Pinoccio/test-pinoccio/README.md

pinoccio-test-harness
=====================
