Pinoccio/test-pinoccio/eagle/pinoccio-test.brd

## EAGLE design eagle/pinoccio-test.brd (2014-06-06)

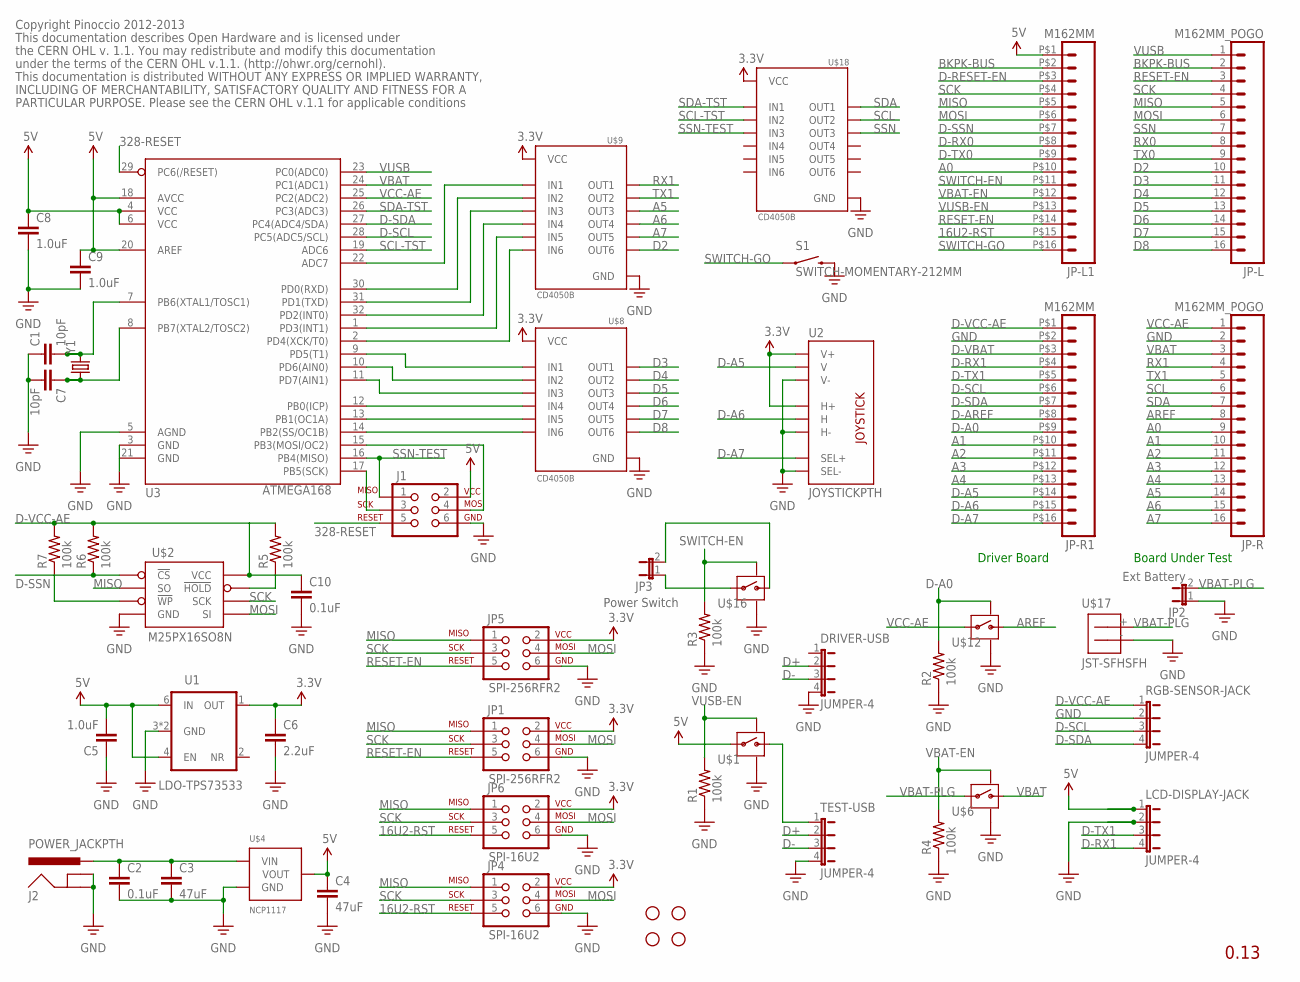
[picture p1: schematic pinoccio-test.sch]

Parts:
C1, C7: 10pF; 0402-CAP
C2, C10: 0.1uF; 0402-CAP
C3, C4: 47uF; 0805
C5, C8, C9: 1.0uF; 0402-CAP
C6: 2.2uF; 0402-CAP
DRIVER-USB: JUMPER-4; 1X04
J1: SPI-328P; 2X3
J2: POWER_JACKPTH; POWER_JACK_PTH
JP1, JP5: SPI-256RFR2; 2X3
JP2: Ext Battery; 1X02
JP3: Power Switch; 1X02
JP4, JP6: SPI-16U2; 2X3
JP7, JP9, JP10, JP12: STAND-OFF
JP-L: M162MM_POGO; 1X16_2MM_POGO
JP-L1: M162MM; 1X16_2MM
JP-R: M162MM_POGO; 1X16_2MM_POGO
JP-R1: M162MM; 1X16_2MM
LCD-DISPLAY-JACK: JUMPER-4; 1X04
R1, R2, R3, R4, R5, R6, R7: 100k; 0402-RES
RGB-SENSOR-JACK: JUMPER-4; 1X04
S1: SWITCH-MOMENTARY-212MM; TACTILE-PTH-12MM
TEST-USB: JUMPER-4; 1X04
U1: LDO-TPS73533; SON-6-DRV
U2: JOYSTICKPTH; JOYSTICK
U3: ATMEGA168; TQFP32-08
U$1, U$6, U$12, U$16: SWITCH-MOSFETTDFN4; TDFN4
U$2: M25PX16SO8N; SO8N
U$4: NCP1117; SOT223
U$8, U$9, U$18: CD4050B; TSSOP-16
U$17: JST-SFHSFH; JST-SFH
Y1: CRYSTALABM10; CRYSTAL-SMD-2.5X2-ABM10

Connections:
3.3V: C6.1, JP1.2, JP4.2, JP5.2, JP6.2, U1.1 (OUT), U2.H1 (H+), U2.V1 (V+), U$8.1 (VCC), U$9.1 (VCC), U$18.1 (VCC)
5V: C4.1, C5.2, C8.1, C9.1, J1.2, JP-L1.P$1 (1), LCD-DISPLAY-JACK.1, U1.4 (EN), U1.6 (IN), U3.4 (VCC), U3.6 (VCC), U3.18 (AVCC), U3.20 (AREF), U$1.P$3 (IN), U$4.2 (VOUT), U$4.4 (VOUT)
16U2-RST: JP4.5, JP6.5, JP-L1.P$15 (15)
328-RESET: J1.5, U3.29 (PC6(/RESET))
A0: JP-L1.P$10 (10), JP-R.9
A1: JP-R.10, JP-R1.P$10 (10)
A2: JP-R.11, JP-R1.P$11 (11)
A3: JP-R.12, JP-R1.P$12 (12)
A4: JP-R.13, JP-R1.P$13 (13)
A5: JP-R.14, U$9.6 (OUT3)
A6: JP-R.15, U$9.10 (OUT4)
A7: JP-R.16, U$9.12 (OUT5)
AREF: JP-R.8, U$12.P$1 (OUT)
BKPK-BUS: JP-L.2, JP-L1.P$2 (2)
D2: JP-L.10, U$9.15 (OUT6)
D3: JP-L.11, U$8.2 (OUT1)
D4: JP-L.12, U$8.4 (OUT2)
D5: JP-L.13, U$8.6 (OUT3)
D6: JP-L.14, U$8.10 (OUT4)
D7: JP-L.15, U$8.12 (OUT5)
D8: JP-L.16, U$8.15 (OUT6)
D+: DRIVER-USB.2, TEST-USB.2
D-: DRIVER-USB.3, TEST-USB.3
D-A0: JP-R1.P$9 (9), R2.2, U$12.P$4 (ON)
D-A5: JP-R1.P$14 (14), U2.V2 (V)
D-A6: JP-R1.P$15 (15), U2.H2 (H)
D-A7: JP-R1.P$16 (16), U2.B1A (SEL+)
D-AREF: JP-R1.P$8 (8)
D-RESET-EN: JP-L1.P$3 (3)
D-RX0: JP-L1.P$8 (8)
D-RX1: JP-R1.P$4 (4), LCD-DISPLAY-JACK.4
D-SCL: JP-R1.P$6 (6), RGB-SENSOR-JACK.3, U3.28 (PC5(ADC5/SCL))
D-SDA: JP-R1.P$7 (7), RGB-SENSOR-JACK.4, U3.27 (PC4(ADC4/SDA))
D-SSN: JP-L1.P$7 (7), R6.1, U$2.1 (!CS)
D-TX0: JP-L1.P$9 (9)
D-TX1: JP-R1.P$5 (5), LCD-DISPLAY-JACK.3
D-VBAT: JP-R1.P$3 (3)
D-VCC-AE: C10.1, JP-R1.P$1 (1), R5.2, R6.2, R7.2, RGB-SENSOR-JACK.1, U$2.8 (VCC)
GND: C1.1, C2.2, C3.2, C4.2, C5.1, C6.2, C7.2, C8.2, C9.2, C10.2, DRIVER-USB.4, J1.6, J2.GND, J2.GNDBREAK, JP1.6, JP2.1, JP4.6, JP5.6, JP6.6, JP-R.2, JP-R1.P$2 (2), LCD-DISPLAY-JACK.2, R1.1, R2.1, R3.1, R4.1, RGB-SENSOR-JACK.2, S1.3 (2), TEST-USB.4, U1.3 (GND), U1.PAD (GND), U2.B2A (SEL-), U2.H3 (H-), U2.V3 (V-), U3.3 (GND), U3.5 (AGND), U$1.P$2 (GND), U$1.P$5 (GND), U$2.4 (GND), U$4.1 (GND), U$6.P$2 (GND), U$6.P$5 (GND), U$8.8 (GND), U$9.8 (GND), U$12.P$2 (GND), U$12.P$5 (GND), U$16.P$2 (GND), U$16.P$5 (GND), U$17.-, U$18.8 (GND), Y1.P$2 (GND), Y1.P$4 (GND)
MISO: JP1.1, JP4.1, JP5.1, JP6.1, JP-L.5, JP-L1.P$5 (5), U$2.2 (SO)
MOSI: JP1.4, JP4.4, JP5.4, JP6.4, JP-L.6, JP-L1.P$6 (6), U$2.5 (SI)
unnamed: U3.2 (PD4(XCK/T0)), U$9.14 (IN6)
unnamed: U3.1 (PD3(INT1)), U$9.11 (IN5)
unnamed: U3.14 (PB2(SS/OC1B)), U$8.14 (IN6)
unnamed: C2.1, C3.1, J2.PWR, U$4.3 (VIN)
unnamed: U3.32 (PD2(INT0)), U$9.9 (IN4)
unnamed: C1.2, U3.7 (PB6(XTAL1/TOSC1)), Y1.P$3 (2)
unnamed: U3.31 (PD1(TXD)), U$9.7 (IN3)
unnamed: U3.13 (PB1(OC1A)), U$8.11 (IN5)
unnamed: U3.30 (PD0(RXD)), U$9.5 (IN2)
unnamed: U3.22 (ADC7), U$9.3 (IN1)
unnamed: U3.12 (PB0(ICP)), U$8.9 (IN4)
unnamed: JP3.2, U$16.P$1 (OUT)
unnamed: U3.11 (PD7(AIN1)), U$8.7 (IN3)
unnamed: C7.1, U3.8 (PB7(XTAL2/TOSC2)), Y1.P$1 (1)
unnamed: JP3.1, U$16.P$3 (IN)
unnamed: TEST-USB.1, U$1.P$1 (OUT)
unnamed: R7.1, U$2.3 (!WP)
unnamed: R5.1, U$2.7 (!HOLD)
unnamed: U3.10 (PD6(AIN0)), U$8.5 (IN2)
unnamed: U3.9 (PD5(T1)), U$8.3 (IN1)
unnamed: J1.4, U3.15 (PB3(MOSI/OC2))
unnamed: J1.3, U3.17 (PB5(SCK))
RESET-EN: JP1.5, JP5.5, JP-L.3, JP-L1.P$14 (14)
RX0: JP-L.8
RX1: JP-R.4, U$9.2 (OUT1)
SCK: JP1.3, JP4.3, JP5.3, JP6.3, JP-L.4, JP-L1.P$4 (4), U$2.6 (SCK)
SCL: JP-R.6, U$18.4 (OUT2)
SCL-TST: U3.19 (ADC6), U$18.5 (IN2)
SDA: JP-R.7, U$18.2 (OUT1)
SDA-TST: U3.26 (PC3(ADC3)), U$18.3 (IN1)
SSN: JP-L.7, U$18.6 (OUT3)
SSN-TEST: J1.1, U3.16 (PB4(MISO)), U$18.7 (IN3)
SWITCH-EN: JP-L1.P$11 (11), R3.2, U$16.P$4 (ON)
SWITCH-GO: JP-L1.P$16 (16), S1.1
TX0: JP-L.9
TX1: JP-R.5, U$9.4 (OUT2)
VBAT: JP-R.3, U3.24 (PC1(ADC1)), U$6.P$1 (OUT)
VBAT-EN: JP-L1.P$12 (12), R4.2, U$6.P$4 (ON)
VBAT-PLG: JP2.2, U$6.P$3 (IN), U$17.+
VCC-AE: JP-R.1, U3.25 (PC2(ADC2)), U$12.P$3 (IN)
VUSB: JP-L.1, U3.23 (PC0(ADC0))
VUSB-EN: JP-L1.P$13 (13), R1.2, U$1.P$4 (ON)

Notes on the sheet:
0.13
Copyright Pinoccio 2012-2013
This documentation describes Open Hardware and is licensed under
the CERN OHL v. 1.1. You may redistribute and modify this documentation
under the terms of the CERN OHL v.1.1. (http://ohwr.org/cernohl).
This documentation is distributed WITHOUT ANY EXPRESS OR IMPLIED WARRANTY,
INCLUDING OF MERCHANTABILITY, SATISFACTORY QUALITY AND FITNESS FOR A
PARTICULAR PURPOSE. Please see the CERN OHL v.1.1 for applicable conditions
Driver Board
Board Under Test

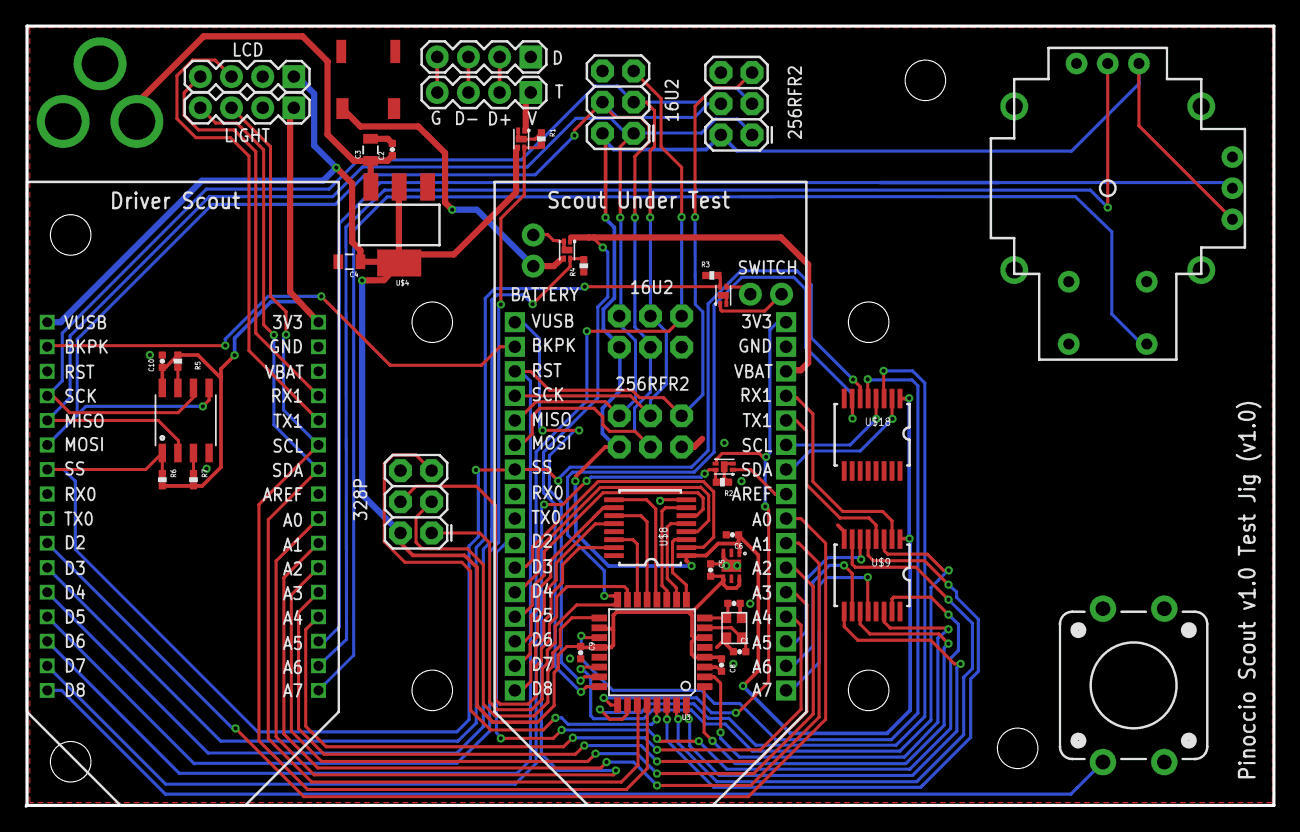
[picture p2: board pinoccio-test.brd from above]

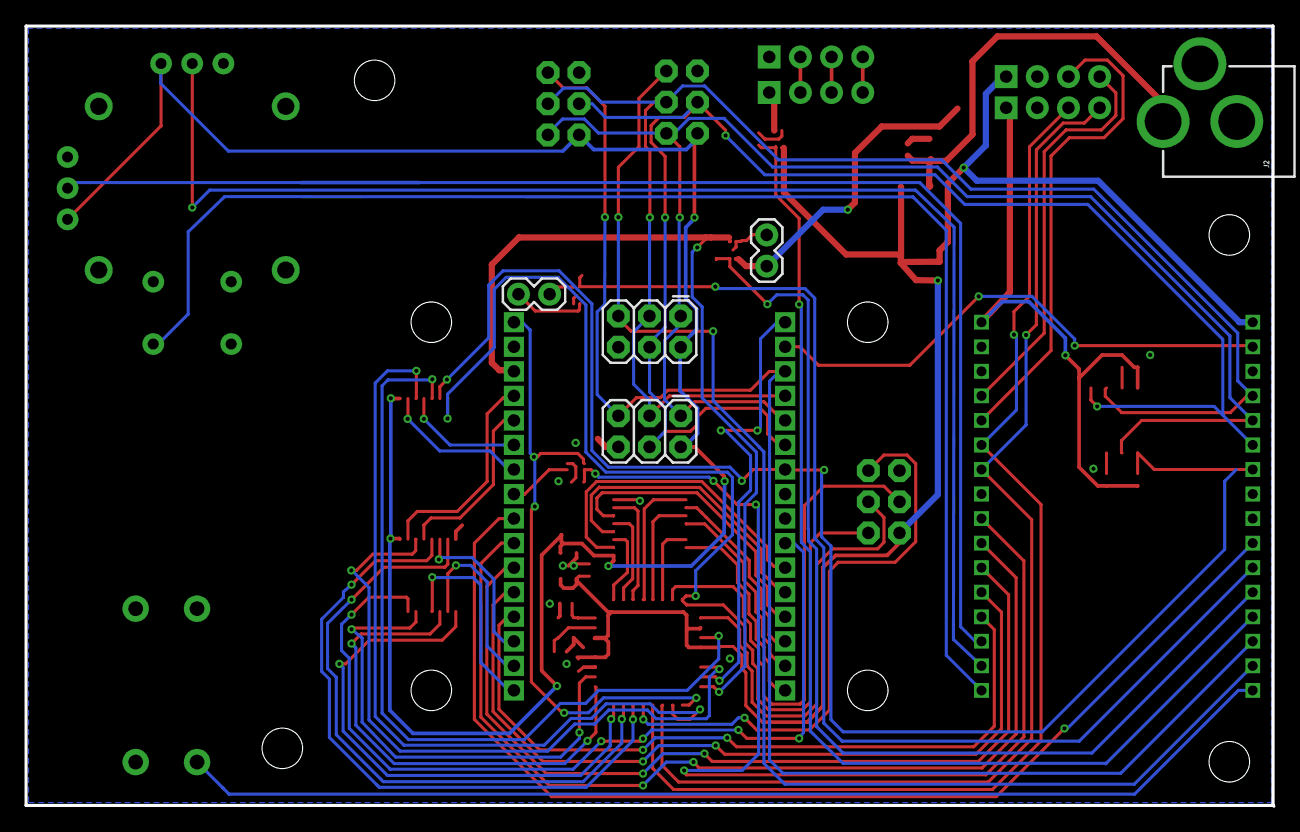
[picture p3: board pinoccio-test.brd from below]

Board: 2 copper layers, 101.6 x 63.5 mm, 56 parts (5 on the bottom side), 76 nets.

Other parts of the board:
JP8, JP11, JP13, JP14: STAND-OFF
