Pinoccio/test-pinoccio/firmware/SerialTunnel/SerialTunnel.ino

void setup() {
  Serial.begin(115200);
  Serial1.begin(115200);
   
  // uncomment these if you want to put the WiFi module into firmware update mode
  //pinMode(6, OUTPUT);
  //digitalWrite(6, HIGH);
  
  pinMode(VCC_ENABLE, OUTPUT);
  digitalWrite(VCC_ENABLE, HIGH);
  pinMode(8, OUTPUT);
  digitalWrite(8, LOW);
  delay(1000);
  digitalWrite(8, HIGH);
}

void loop() {

  // read from port 1, send to port 0:
  while (Serial1.available()) {
    int inByte = Serial1.read();
    Serial.write(inByte); 
  }

  // read from port 0, send to port 1:
  while (Serial.available()) {
    int inByte = Serial.read();
    Serial1.write(inByte); 
  }
}
