Pinoccio/test-pinoccio/firmware/PinoccioTestSuite/bootloader_atmega256rfr2.h

// ---------------------------------------------------------
// File =  boot_pinoccio.hex
// Loader start: 3E000, length: 8192
// MD5 sum = 85 11 97 C0 F7 AF 96 CC B7 A1 2E F6 38 16 53 92 

const byte PROGMEM atmega256rfr2_bootloader [] = {
0x99, 0xC0, 0x00, 0x00, 0xBE, 0xC0, 0x00, 0x00, 0xBC, 0xC0, 0x00, 0x00, 0xBA, 0xC0, 0x00, 0x00, 
0xB8, 0xC0, 0x00, 0x00, 0xB6, 0xC0, 0x00, 0x00, 0xB4, 0xC0, 0x00, 0x00, 0xB2, 0xC0, 0x00, 0x00, 
0xB0, 0xC0, 0x00, 0x00, 0xAE, 0xC0, 0x00, 0x00, 0xAC, 0xC0, 0x00, 0x00, 0xAA, 0xC0, 0x00, 0x00, 
0xA8, 0xC0, 0x00, 0x00, 0xA6, 0xC0, 0x00, 0x00, 0xA4, 0xC0, 0x00, 0x00, 0xA2, 0xC0, 0x00, 0x00, 
0xA0, 0xC0, 0x00, 0x00, 0x9E, 0xC0, 0x00, 0x00, 0x9C, 0xC0, 0x00, 0x00, 0x9A, 0xC0, 0x00, 0x00, 
0x98, 0xC0, 0x00, 0x00, 0x96, 0xC0, 0x00, 0x00, 0x94, 0xC0, 0x00, 0x00, 0x92, 0xC0, 0x00, 0x00, 
0x90, 0xC0, 0x00, 0x00, 0x8E, 0xC0, 0x00, 0x00, 0x8C, 0xC0, 0x00, 0x00, 0x8A, 0xC0, 0x00, 0x00, 
0x88, 0xC0, 0x00, 0x00, 0x86, 0xC0, 0x00, 0x00, 0x84, 0xC0, 0x00, 0x00, 0x82, 0xC0, 0x00, 0x00, 
0x80, 0xC0, 0x00, 0x00, 0x7E, 0xC0, 0x00, 0x00, 0x7C, 0xC0, 0x00, 0x00, 0x7A, 0xC0, 0x00, 0x00, 
0x78, 0xC0, 0x00, 0x00, 0x76, 0xC0, 0x00, 0x00, 0x74, 0xC0, 0x00, 0x00, 0x72, 0xC0, 0x00, 0x00, 
0x70, 0xC0, 0x00, 0x00, 0x6E, 0xC0, 0x00, 0x00, 0x6C, 0xC0, 0x00, 0x00, 0x6A, 0xC0, 0x00, 0x00, 
0x68, 0xC0, 0x00, 0x00, 0x66, 0xC0, 0x00, 0x00, 0x64, 0xC0, 0x00, 0x00, 0x62, 0xC0, 0x00, 0x00, 
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
0xFF, 0x90, 0xC5, 0xCF, 0xDF, 0x92, 0xEF, 0x92, 0xFF, 0x92, 0x0F, 0x93, 0x1F, 0x93, 0xCF, 0x93, 
0xDF, 0x93, 0x8C, 0x01, 0xD6, 0x2E, 0x7A, 0x01, 0xE9, 0x01, 0x20, 0x97, 0x49, 0xF0, 0x47, 0xE0, 
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
}; // end of boot_pinoccio_hex
