Pinoccio/test-pinoccio/firmware/PinoccioTestSuiteI2C/bootloader_atmega256rfr2.h

// File =  atmega256rfr2.hex
// Loader start: 3E000, length: 8192
// MD5 sum = 04 1A 16 F4 9A CE 01 A2 22 EB CB 41 4E DA 70 F1 

const byte PROGMEM atmega256rfr2_bootloader [] = {
0x0D, 0x94, 0xB4, 0xF1, 0x0D, 0x94, 0xDD, 0xF1, 0x0D, 0x94, 0xDD, 0xF1, 0x0D, 0x94, 0xDD, 0xF1, 
0x0D, 0x94, 0xDD, 0xF1, 0x0D, 0x94, 0xDD, 0xF1, 0x0D, 0x94, 0xDD, 0xF1, 0x0D, 0x94, 0xDD, 0xF1, 
0x0D, 0x94, 0xDD, 0xF1, 0x0D, 0x94, 0xDD, 0xF1, 0x0D, 0x94, 0xDD, 0xF1, 0x0D, 0x94, 0xDD, 0xF1, 
0x0D, 0x94, 0xDD, 0xF1, 0x0D, 0x94, 0xDD, 0xF1, 0x0D, 0x94, 0xDD, 0xF1, 0x0D, 0x94, 0xDD, 0xF1, 
0x0D, 0x94, 0xDD, 0xF1, 0x0D, 0x94, 0xDD, 0xF1, 0x0D, 0x94, 0xDD, 0xF1, 0x0D, 0x94, 0xDD, 0xF1, 
0x0D, 0x94, 0xDD, 0xF1, 0x0D, 0x94, 0xDD, 0xF1, 0x0D, 0x94, 0xDD, 0xF1, 0x0D, 0x94, 0xDD, 0xF1, 
0x0D, 0x94, 0xDD, 0xF1, 0x0D, 0x94, 0xDD, 0xF1, 0x0D, 0x94, 0xDD, 0xF1, 0x0D, 0x94, 0xDD, 0xF1, 
0x0D, 0x94, 0xDD, 0xF1, 0x0D, 0x94, 0xDD, 0xF1, 0x0D, 0x94, 0xDD, 0xF1, 0x0D, 0x94, 0xDD, 0xF1, 
0x0D, 0x94, 0xDD, 0xF1, 0x0D, 0x94, 0xDD, 0xF1, 0x0D, 0x94, 0xDD, 0xF1, 0x0D, 0x94, 0xDD, 0xF1, 
0x0D, 0x94, 0xDD, 0xF1, 0x0D, 0x94, 0xDD, 0xF1, 0x0D, 0x94, 0xDD, 0xF1, 0x0D, 0x94, 0xDD, 0xF1, 
0x0D, 0x94, 0xDD, 0xF1, 0x0D, 0x94, 0xDD, 0xF1, 0x0D, 0x94, 0xDD, 0xF1, 0x0D, 0x94, 0xDD, 0xF1, 
0x0D, 0x94, 0xDD, 0xF1, 0x0D, 0x94, 0xDD, 0xF1, 0x0D, 0x94, 0xDD, 0xF1, 0x0D, 0x94, 0xDD, 0xF1, 
0x0D, 0x94, 0xDD, 0xF1, 0x0D, 0x94, 0xDD, 0xF1, 0x0D, 0x94, 0xDD, 0xF1, 0x0D, 0x94, 0xDD, 0xF1, 
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
0x63, 0x74, 0x69, 0x6F, 0x6E, 0x20, 0x61, 0x64, 0x64, 0x72, 0x20, 0x20, 0x20, 0x49, 0x6E, 0x74, 
0x65, 0x72, 0x72, 0x75, 0x70, 0x74, 0x00, 0x34, 0x2E, 0x37, 0x2E, 0x33, 0x00, 0x31, 0x2E, 0x38, 
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
}; // end of atmega256rfr2_hex
