Pinoccio/test-pinoccio/firmware/PinoccioTestSuiteI2C/bootloader_attiny13a.h

const byte PROGMEM attiny13a [] = {
0x3a, 0x31, 0x30, 0x30, 0x30, 0x30, 0x30, 0x30, 0x30, 0x30, 0x39, 0x43, 0x30, 0x43, 0x33, 0x43, 0x30, 0x30, 0x44, 0x43, 0x30, 0x30, 0x43, 0x43, 0x30, 0x30, 0x42, 0x43, 0x30, 0x30, 0x41, 0x43, 0x30, 0x32, 0x39, 0x43, 0x31, 0x36, 0x42, 0x43, 0x31, 0x36, 0x30, 0x0d, 0x0a, 0x3a, 0x31, 0x30, 0x30, 0x30, 0x31, 0x30, 0x30, 0x30, 0x30, 0x37, 0x43, 0x30, 0x30, 0x36, 0x43, 0x30, 0x31, 0x31, 0x32, 0x34, 0x31, 0x46, 0x42, 0x45, 0x43, 0x46, 0x45, 0x39, 0x43, 0x44, 0x42, 0x46, 0x38, 0x36, 0x44, 0x31, 0x38, 0x38, 0x43, 0x31, 0x35, 0x44, 0x0d, 0x0a, 0x3a, 0x31, 0x30, 0x30, 0x30, 0x32, 0x30, 0x30, 0x30, 0x45, 0x46, 0x43, 0x46, 0x31, 0x30, 0x45, 0x30, 0x35, 0x35, 0x32, 0x34, 0x35, 0x41, 0x39, 0x34, 0x38, 0x45, 0x45, 0x46, 0x36, 0x38, 0x32, 0x32, 0x37, 0x31, 0x32, 0x43, 0x38, 0x31, 0x32, 0x43, 0x36, 0x41, 0x0d, 0x0a, 0x3a, 0x31, 0x30, 0x30, 0x30, 0x33, 0x30, 0x30, 0x30, 0x38, 0x35, 0x45, 0x31, 0x38, 0x37, 0x42, 0x42, 0x38, 0x38, 0x42, 0x42, 0x38, 0x39, 0x45, 0x36, 0x38, 0x39, 0x42, 0x44, 0x38, 0x30, 0x45, 0x34, 0x38, 0x42, 0x42, 0x46, 0x38, 0x32, 0x45, 0x30, 0x31, 0x30, 0x0d, 0x0a, 0x3a, 0x31, 0x30, 0x30, 0x30, 0x34, 0x30, 0x30, 0x30, 0x38, 0x33, 0x42, 0x46, 0x38, 0x35, 0x42, 0x37, 0x38, 0x30, 0x36, 0x32, 0x38, 0x35, 0x42, 0x46, 0x37, 0x38, 0x39, 0x34, 0x30, 0x38, 0x39, 0x35, 0x38, 0x35, 0x45, 0x30, 0x37, 0x38, 0x31, 0x32, 0x37, 0x34, 0x0d, 0x0a, 0x3a, 0x31, 0x30, 0x30, 0x30, 0x35, 0x30, 0x30, 0x30, 0x36, 0x43, 0x43, 0x30, 0x38, 0x38, 0x32, 0x44, 0x38, 0x34, 0x33, 0x30, 0x44, 0x31, 0x46, 0x31, 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
}; // end
