Pinoccio/test-pinoccio/firmware/PinoccioTestSuiteI2C/flash_atmega256rfr2.h

const byte PROGMEM atmega256rfr2_flash_0 [] = {
0x0C, 0x94, 0xA4, 0x04, 0x0C, 0x94, 0xD5, 0x04, 0x0C, 0x94, 0xD5, 0x04, 0x0C, 0x94, 0xD5, 0x04, 
0x0C, 0x94, 0xD5, 0x04, 0x0C, 0x94, 0xD5, 0x04, 0x0C, 0x94, 0xD5, 0x04, 0x0C, 0x94, 0xD5, 0x04, 
0x0C, 0x94, 0xD5, 0x04, 0x0C, 0x94, 0xD5, 0x04, 0x0C, 0x94, 0xD5, 0x04, 0x0C, 0x94, 0xD5, 0x04, 
0x0C, 0x94, 0xD5, 0x04, 0x0C, 0x94, 0xC5, 0x2A, 0x0C, 0x94, 0xD5, 0x04, 0x0C, 0x94, 0xD5, 0x04, 
0x0C, 0x94, 0xD5, 0x04, 0x0C, 0x94, 0xD5, 0x04, 0x0C, 0x94, 0xD5, 0x04, 0x0C, 0x94, 0xD5, 0x04, 
0x0C, 0x94, 0xD5, 0x04, 0x0C, 0x94, 0xD5, 0x04, 0x0C, 0x94, 0xD5, 0x04, 0x0C, 0x94, 0x1E, 0x4B, 
0x0C, 0x94, 0xD5, 0x04, 0x0C, 0x94, 0x6B, 0x4F, 0x0C, 0x94, 0xEB, 0x4F, 0x0C, 0x94, 0xD5, 0x04, 
0x0C, 0x94, 0xD5, 0x04, 0x0C, 0x94, 0x6C, 0x2B, 0x0C, 0x94, 0xD5, 0x04, 0x0C, 0x94, 0xD5, 0x04, 
0x0C, 0x94, 0xD5, 0x04, 0x0C, 0x94, 0xD5, 0x04, 0x0C, 0x94, 0xD5, 0x04, 0x0C, 0x94, 0xD5, 0x04, 
0x0C, 0x94, 0xA3, 0x4F, 0x0C, 0x94, 0x2A, 0x50, 0x0C, 0x94, 0xD5, 0x04, 0x0C, 0x94, 0x3E, 0x0D, 
0x0C, 0x94, 0xD5, 0x04, 0x0C, 0x94, 0xD5, 0x04, 0x0C, 0x94, 0xC4, 0x2B, 0x0C, 0x94, 0xD5, 0x2B, 
0x0C, 0x94, 0xD5, 0x04, 0x0C, 0x94, 0xD5, 0x04, 0x0C, 0x94, 0xD5, 0x04, 0x0C, 0x94, 0xD5, 0x04, 
0x0C, 0x94, 0xD5, 0x04, 0x0C, 0x94, 0xD5, 0x04, 0x0C, 0x94, 0xD5, 0x04, 0x0C, 0x94, 0xD5, 0x04, 
0x0C, 0x94, 0xD5, 0x04, 0x0C, 0x94, 0xD5, 0x04, 0x0C, 0x94, 0xD5, 0x04, 0x0C, 0x94, 0xD5, 0x04, 
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
0x19, 0xC0, 0xF8, 0x01, 0xE2, 0x59, 0xFF, 0x4F, 0x80, 0x81, 0x95, 0xE0, 0x89, 0x9F, 0x00, 0x0D, 
0x11, 0x1D, 0x11, 0x24, 0x09, 0xC0, 0xF8, 0x01, 0xE2, 0x59, 0xFF, 0x4F, 0x80, 0x81, 0xE5, 0xE0, 
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
}; // end of Scout_cpp_hex
