Pinoccio/test-pinoccio/(commit log)

2013-10-16 Inital import
    [pinoccio-test-middle.brd, pinoccio-test-top-left.brd, pinoccio-test-top-right.brd, pinoccio-test-top.brd, pinoccio-test.brd, pinoccio-test.sch]
2013-10-27 Got i2c stuff talking between driver board and 328p
2013-10-28 Got all IO pin control working (except for the two that are ADC-only
2013-10-31 Fix #6: finish power supply testing
    [AVR328Driver.ino, PinoccioTestSuite.ino]
2013-11-08 Got hex image in serial flash to write to 256RFR2 correctly
    [DriverFlashWriter.ino, PinoccioTestSuite.ino, programmer.cpp, programmer.h]
2013-11-10 More debug clenaup, got power completed, working on reset now
    [AVR328Driver.ino, PinoccioTestSuite.ino, SerialTunnel.ino, programmer.cpp, programmer.h]
2013-11-13 Fix #4: gpio now is tested!
    [AVR328Driver.ino, PinoccioTestSuiteI2C.ino, bootloader_atmega16u2.h, bootloader_atmega256rfr2.h, bootloader_attiny13a.h, flash_atmega256rfr2.h, md5.c]
2013-11-27 tightened up the 3V3 power checks
    [PinoccioTestSuite.ino]
2013-11-27 Got close to having mesh done, couple loose ends
    [PinoccioTestSuite.ino]
2013-12-20 Final fixups for test jig 1.0
    [DriverFlashReader.ino, DriverFlashWriter.ino, PinoccioTestSuite.ino, PinoccioTestSuiteI2C.ino, bootloader_atmega256rfr2.h, programmer.cpp, programmer.h, serialwrite.py]
2013-12-30 make longer timeout for 3V3 check, and explicitly reset the chip-select pins between chip flashes
    [PinoccioTestSuite.ino]
2014-02-17 Include GS.h from PinoccioTestSuite sketch
    The pinoccio-arduino-library depends on the GS library, but the IDE
    doesn't know how to automatically include it in the build yet.
    [PinoccioTestSuite.ino]
2014-02-17 Include string.h from md5.c for memcpy
    This prevents a compiler warning
    [md5.c]
2014-02-18 Adjust timeout timing issues
    [PinoccioTestSuite.ino]
2014-02-18 Fix remaining disableShell issue
    [PinoccioTestSuite.ino]
2014-06-06 Clean up SPI chip select
    [pinoccio-test.brd]
2014-06-06 Fix up some brokenness in the test firmware
    [PinoccioTestSuite.ino, bootloader_atmega256rfr2.h, programmer.cpp]
2014-06-06 Add multiple checks for 3.3v for sag
    [PinoccioTestSuite.ino]
2014-06-11 Loosen up prompt checking from being so strict
    [PinoccioTestSuite.ino]
2016-09-20 Added adjustment of VUSB gate pin to handle the new p-channel mosfet which requires an active-low to enable
2016-09-20 Cleaned up SPI comms between calls to prevent a hung bus
    [programmer.cpp, programmer.h]
